century-synthetics/bt-button-box/schematics/bt-button-box.pdf

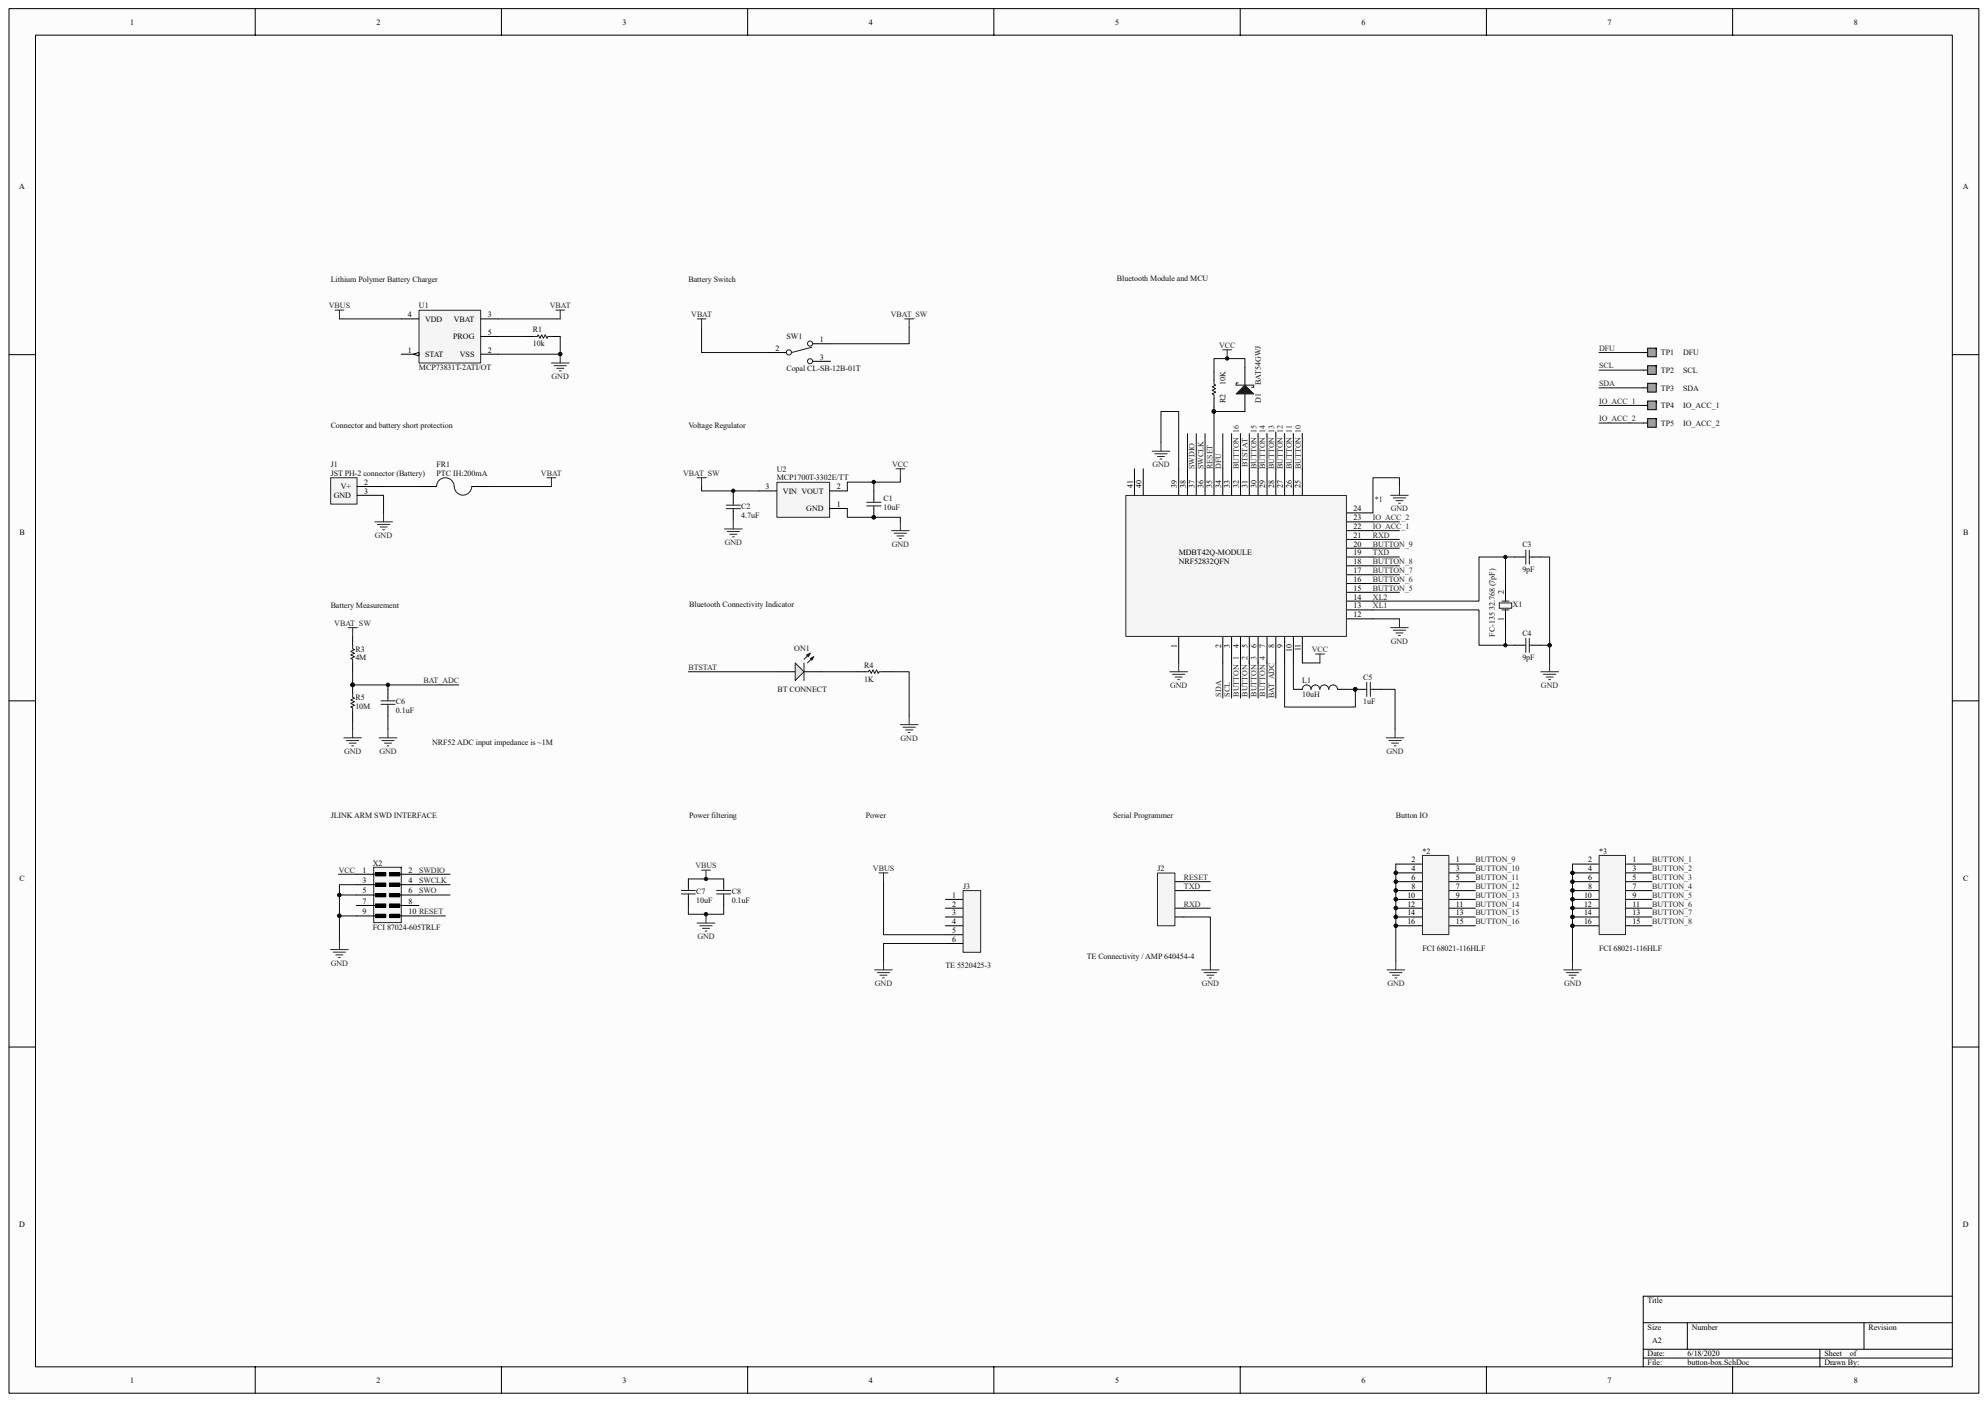
[picture p2: page 1]

Connector and battery short protection

JST PH-2 connector (Battery)

P0.11 25 P0.12 26 P0.13 27 P0.14 28 P0.15 29 P0.16 30 P0.17 31 P0.18 32 P0.19 33 P0.20 34 P0.21/RESET 35 SWDCLK 36 SWDIO 37 P0.22 38 GND 39

NRF52 ADC input impedance is ~1M

JLINK ARM SWD INTERFACE

Size A2 | Number | Revision

Date: 6/18/2020 | Sheet of
File: button-box.SchDoc | Drawn By:
