century-synthetics/bt-button-box/(commit log)

2020-06-18 Create bt-button-box.pdf
    Adding schematic
2020-06-19 Updated documentation
    Updating documentation to include a better readme with usage information. Updated documentation of the HID device in the library snapshot.
2020-06-21 Removing battery service as it won't be accurate. Adding bootloaders. Re enabling 12c pins.
    [bluetooth.cpp, bluetooth.h, button-box.ino, config.h]
2020-08-04 Adding instructions about different variants of the NRF52832 board. Adding a Q&A section for some common questions so far.
2020-08-08 updating pinout configs to use pin 31 to better fit in the accuforce v2 housing.
